vikvs64/pmod-dvi/PMOD_connected.jpg

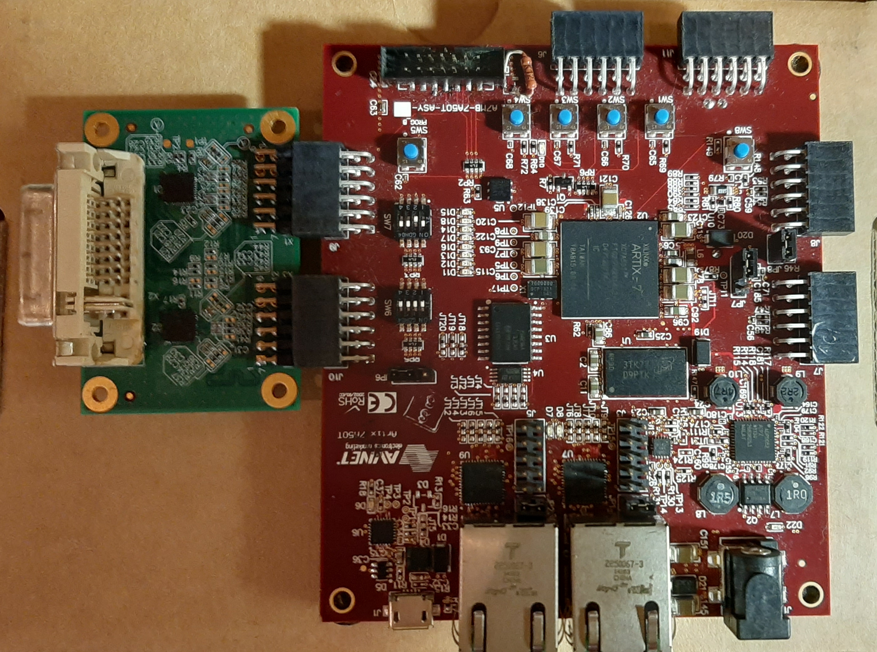
PMOD_connected.jpg
