vikvs64/pmod-dvi/PMOD_DVI_D.jpg

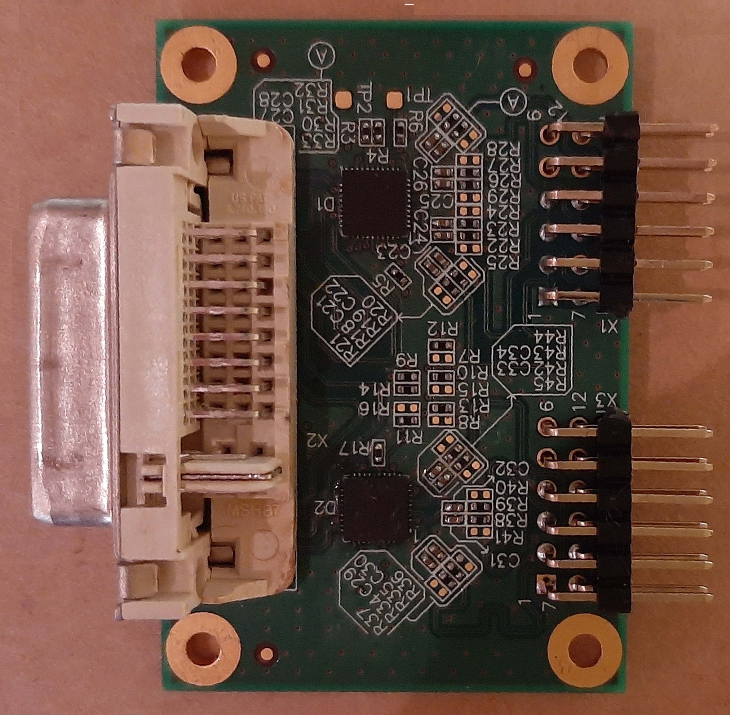
PMOD_DVI_D.jpg
