vikvs64/pmod-dvi/README.md

# pmod-dvi open source hardware project

Wide DVI display controller with PMOD interface

Tested in 1920x1080@120Hz mode with Digilent's Genesys-2 Board. Fpga test based on Will Green's Verilog [code](https://projectf.io/posts/video-timings-vga-720p-1080p/) 
This code also avaliable on GitHub: [projf project](https://github.com/projf/display_controller)

Hardware design based on TI's [SN75DP139RSBR](https://www.ti.com/product/SN75DP139) Chip with TMDS Clock Rates up to 340 MHz. Complete set of files for manufacturing are includes

## Pmod foto
Pmod

## Project structure

    HW - schematic and design files (BOM, Gerbers ...)

    HDL - Double link 1920x1080@120Hz mode test design Verilog source files for Genesys-2 Demo Board 

## More fotos

Genesys-2 Board with PMOD connected

1920x1080@120Hz picture
