vikvs64/pmod-dvi/hw/PMOD DVI-D_BOM_v1.1.xls

Designator | UID | Manufacturer | Partnumber | Size | Value | TC | Voltage | Tolerance | Quantity | DoNotPlace
C1, C2, C11, C12 | C-0402-X5R-16-1uF M | Murata | - | 0402 | 1uF | X5R | 16V | 20% | 4
C3, C4, C5, C6, C7, C8, C9, C10, C13, C14, C15, C16, C17, C18, C19, C20, C21, C22, C23, C24, C25, C26, C27, C28, C29, C30, C31, C32, C33, C34 | C-0402-X7R-16-0.1uF M | Murata | - | 0402 | 0.1uF | X7R | 16V | 20% | 30
D1, D2 | D-SN75DP139RSBR | Texas Instruments | SN75DP139RSBR | - | - | - | - | - | 2
L1, L2 | F-BLM18AG121SN1D | Murata | BLM18AG121SN1D | 0603 | 120R | - | - |  | 2
R1, R2, R7, R8, R15, R16 | R-0402-4K7 F | Yageo | - | 0402 | 4.7k | - | - | 1% | 6 | DNP
R3, R4, R9, R10, R11, R12, R13, R14 | R-0402-4K7 F | Yageo | - | 0402 | 4.7k | - | - | 1% | 8
R5 | R-0402-150R F | Yageo | - | 0402 | 150 | - | - | 1% | 1
R6, R17 | R-0402-4K02 F | Yageo | - | 0402 | 4.02k | - | - | 1% | 2
R18, R19, R22, R23, R26, R27, R30, R31, R34, R35, R38, R39, R42, R43 | R-0402-0R F | Yageo | - | 0402 | 0 | - | - | - | 14
R20, R21, R24, R25, R28, R29, R32, R33, R36, R37, R40, R41, R44, R45 | R-0402-49R9 F | Yageo | - | 0402 | 49.9 | - | - | 1% | 14 | DNP
R46, R47, R48, R49, R50, R51, R52, R53, R54, R55, R56, R57, R58, R59 | R-0402-49R9 F | Yageo | - | 0402 | 49.9 | - | - | 1% | 14
X1, X3 | X-PLD-12R | - | PLD-12R | - | - | - | - | - | 2
X2 | X-0743201004 | Molex | 743201004 | - | - | - | - | - | 1
