vikvs64/pmod-dvi/hw/PMOD_DVI-D_Board_Assembly.PDF

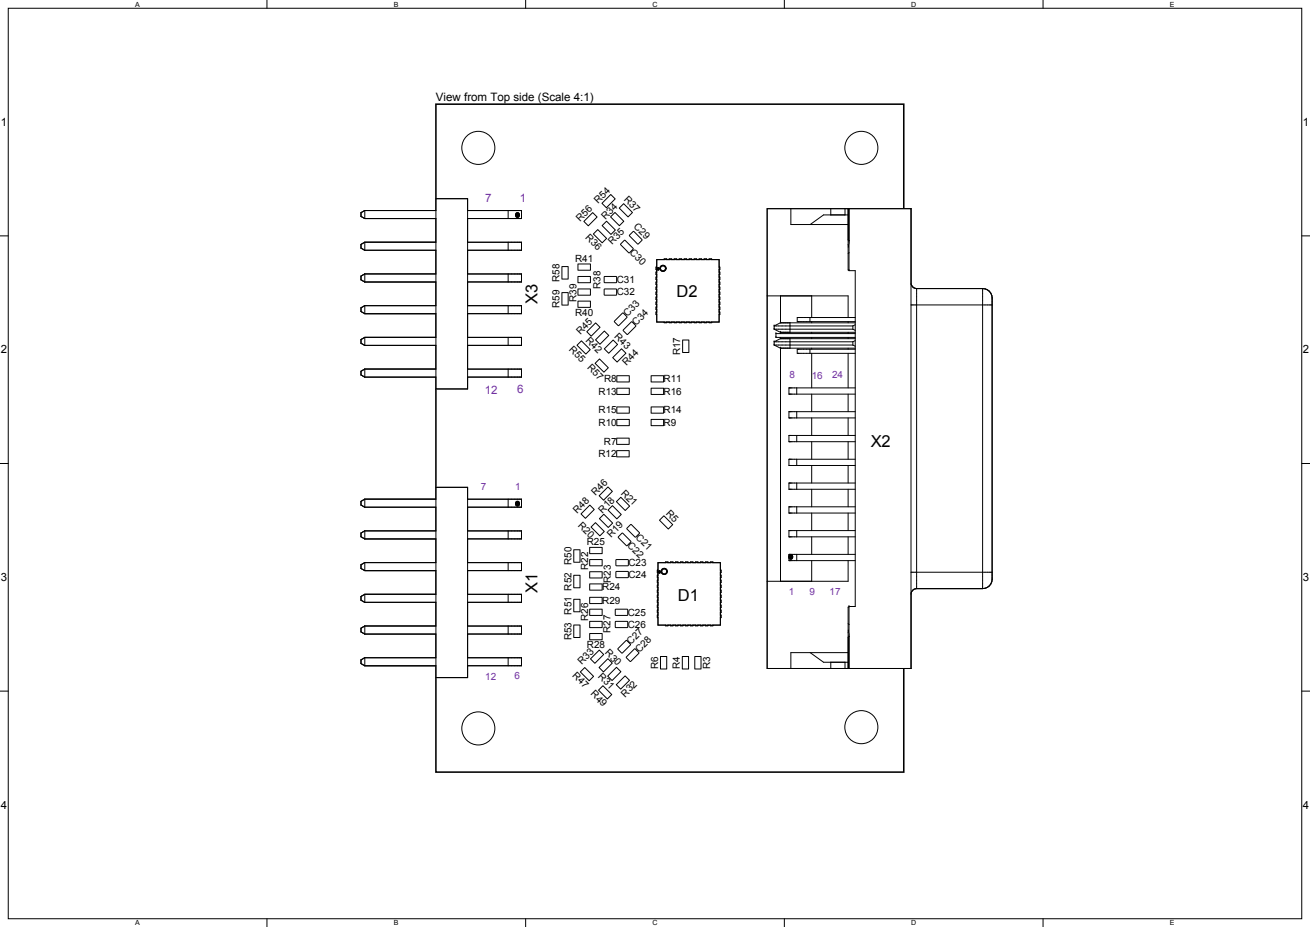
[picture p3: page 1]

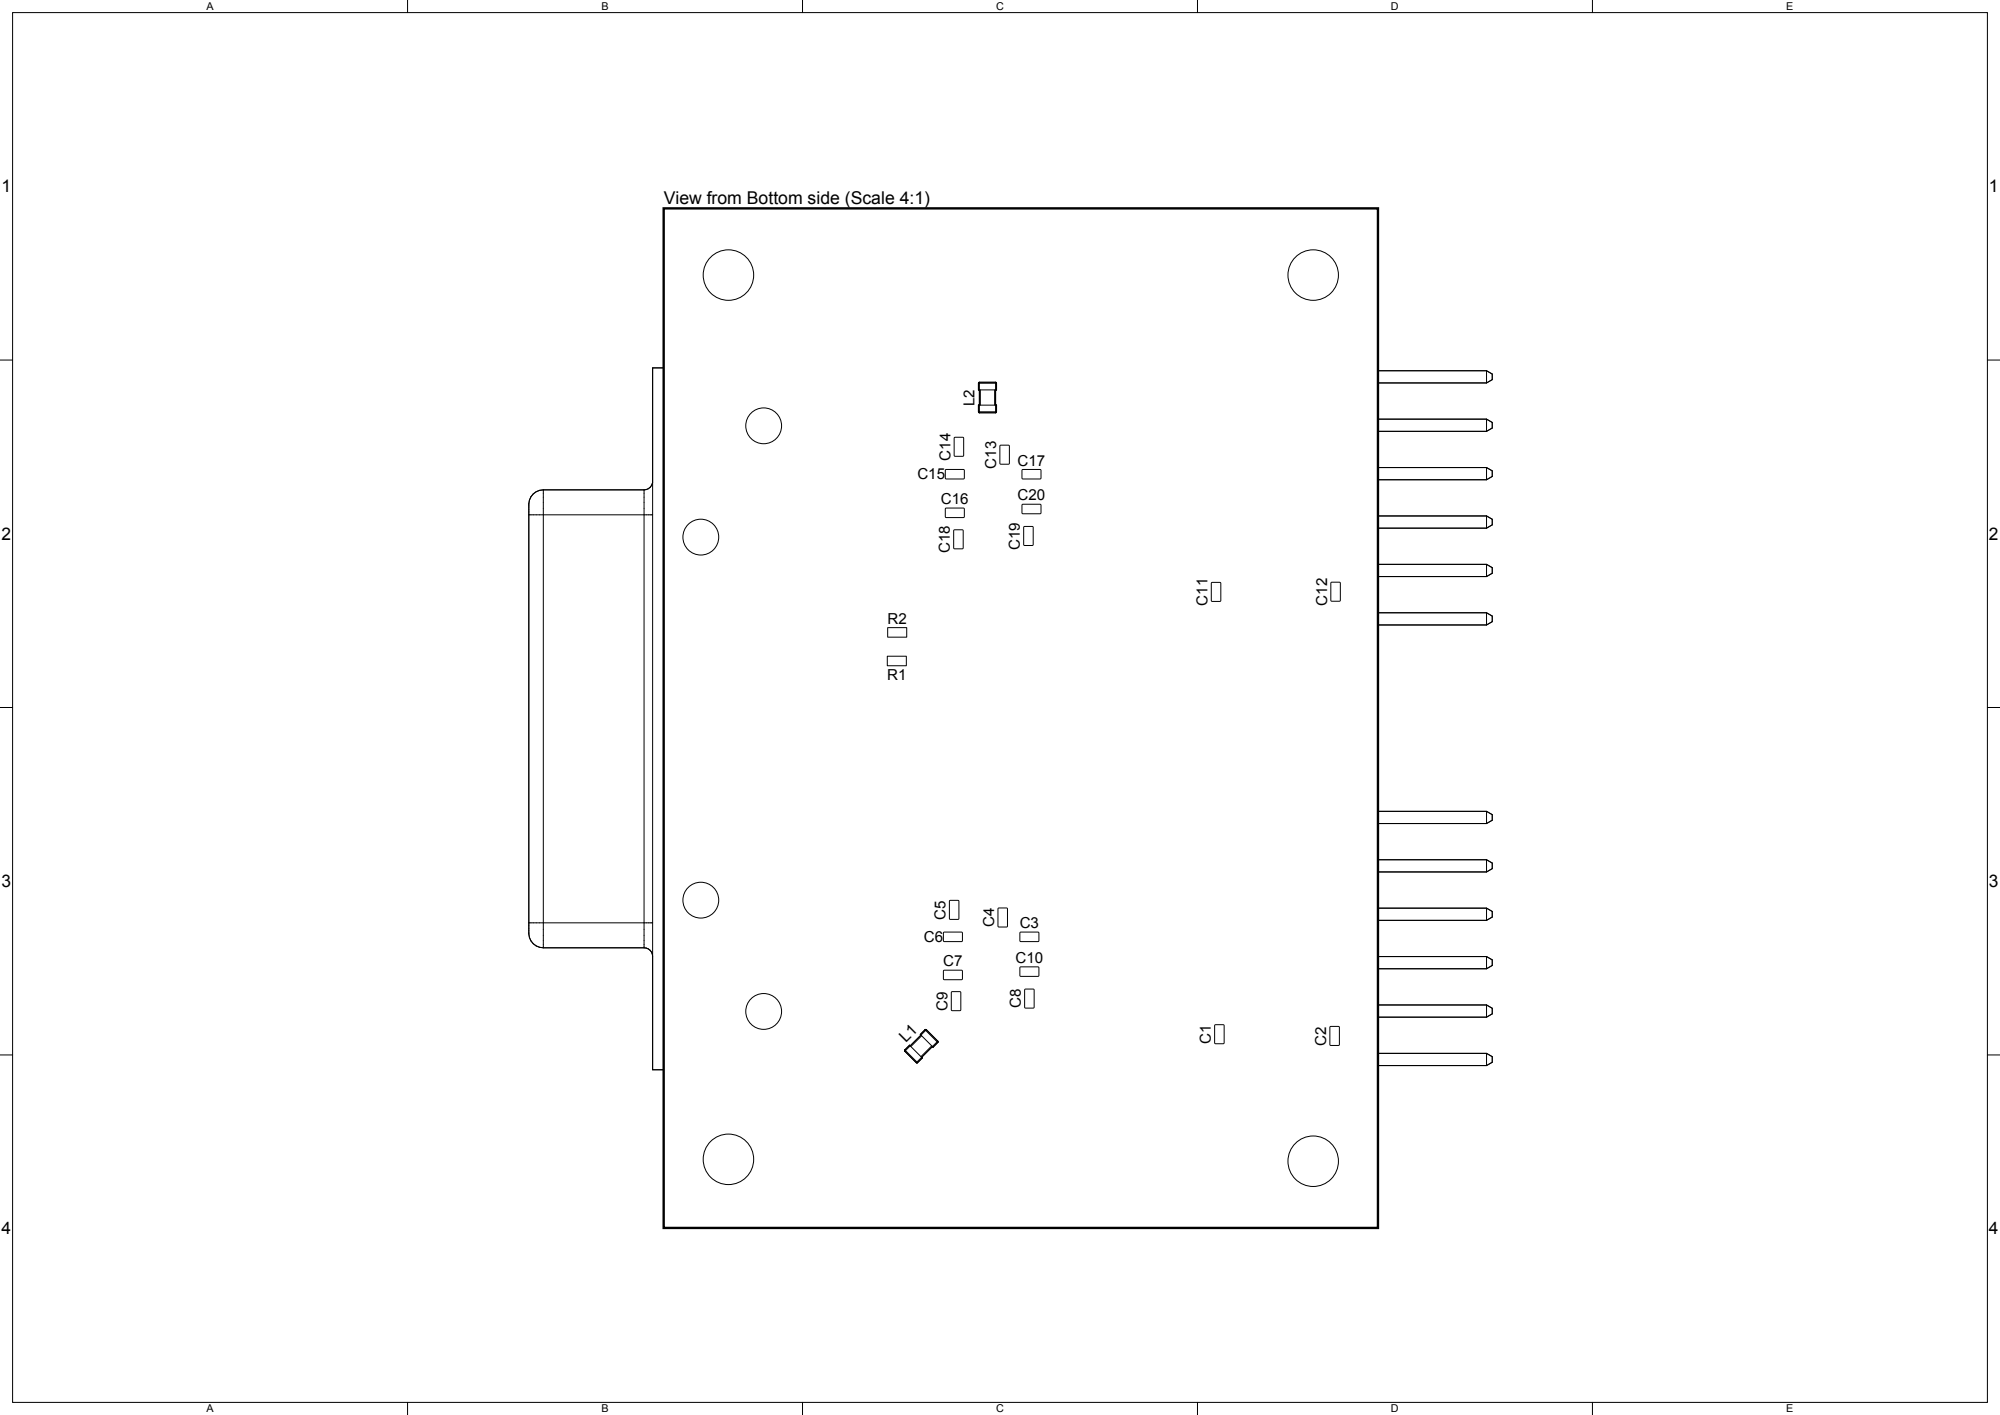
[picture p4: page 2]

View from Bottom side (Scale 4:1)

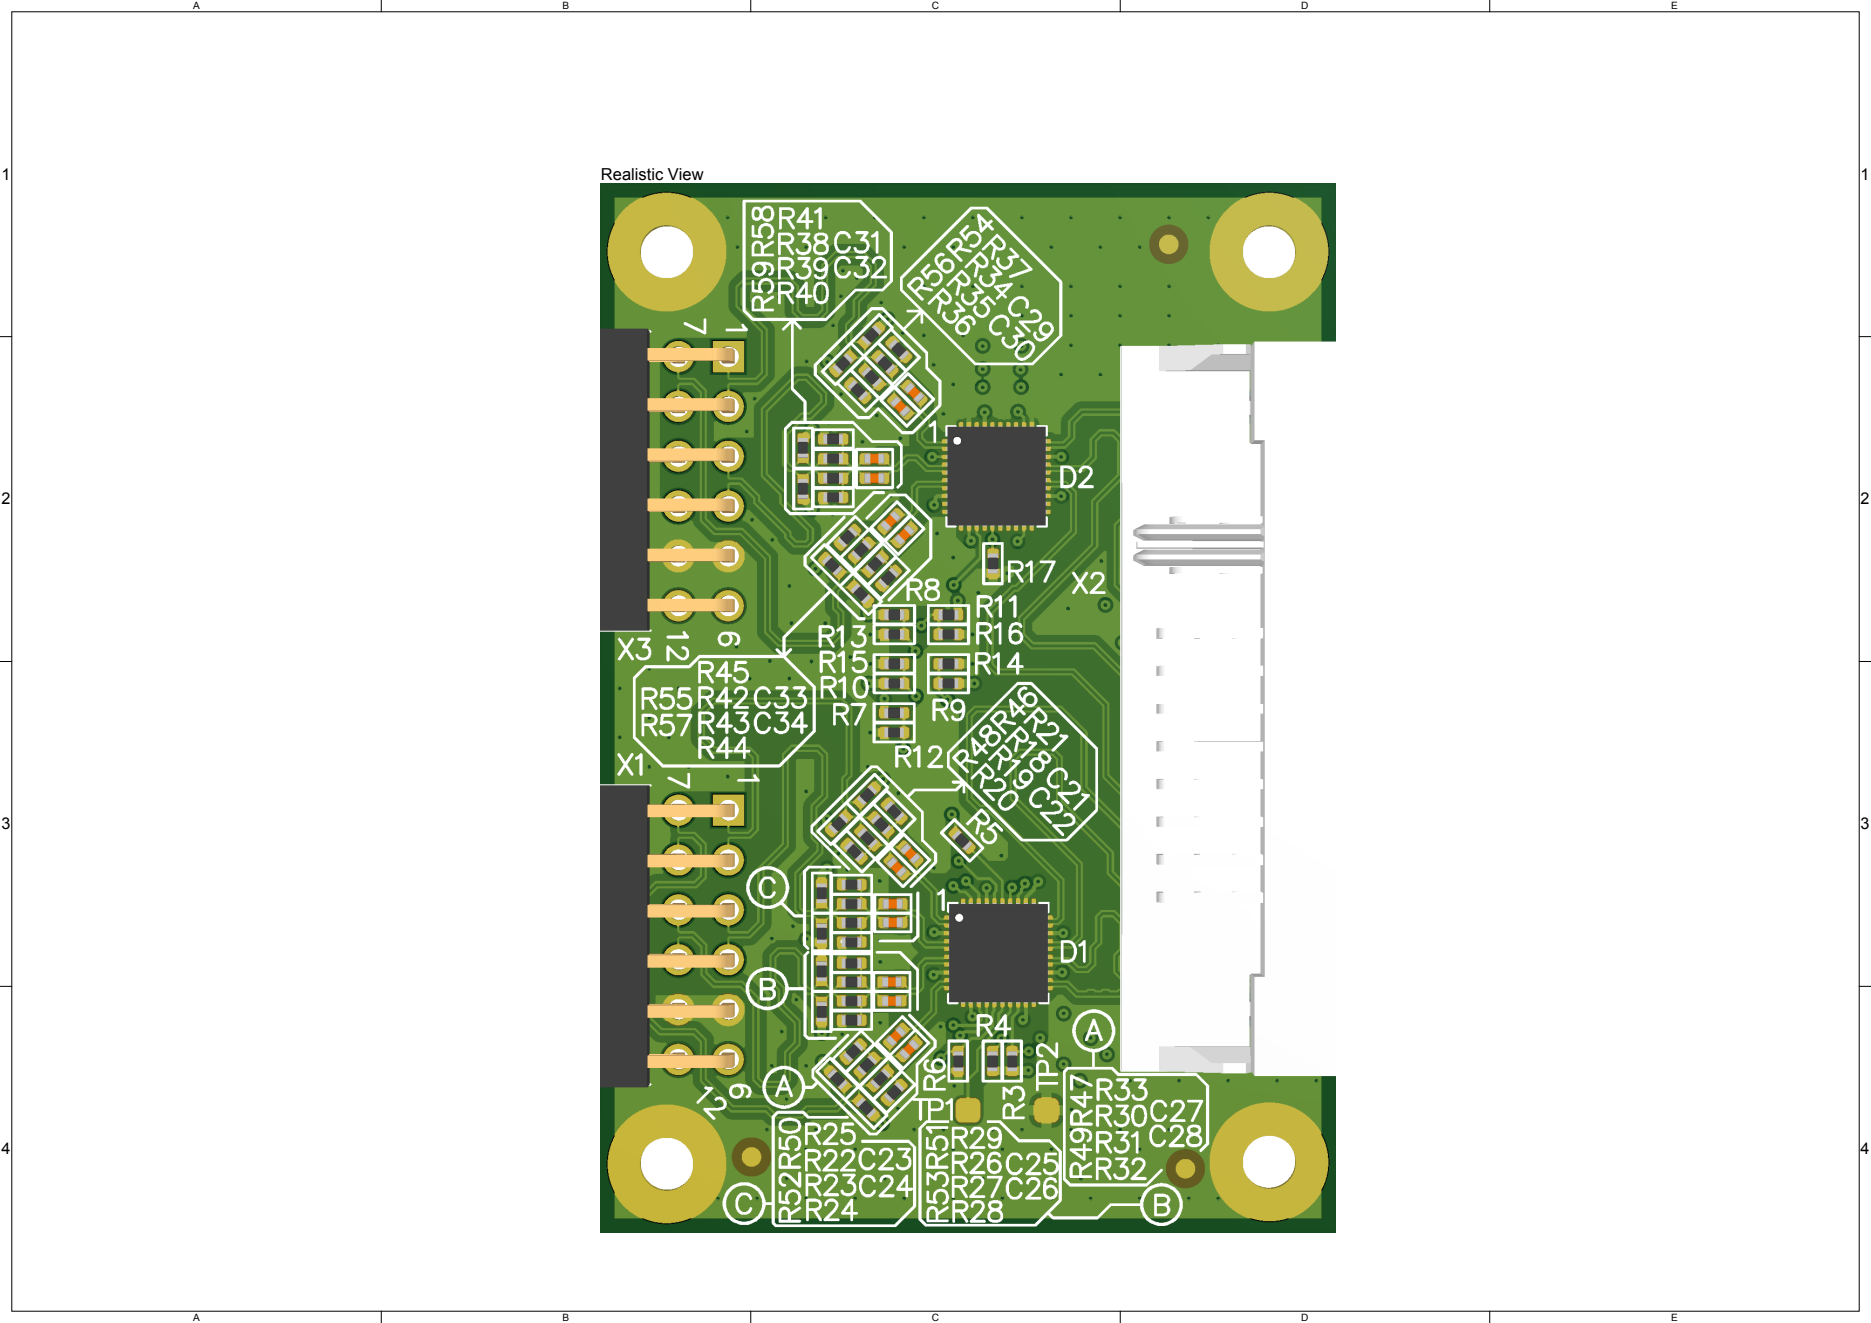
[picture p5: page 3]

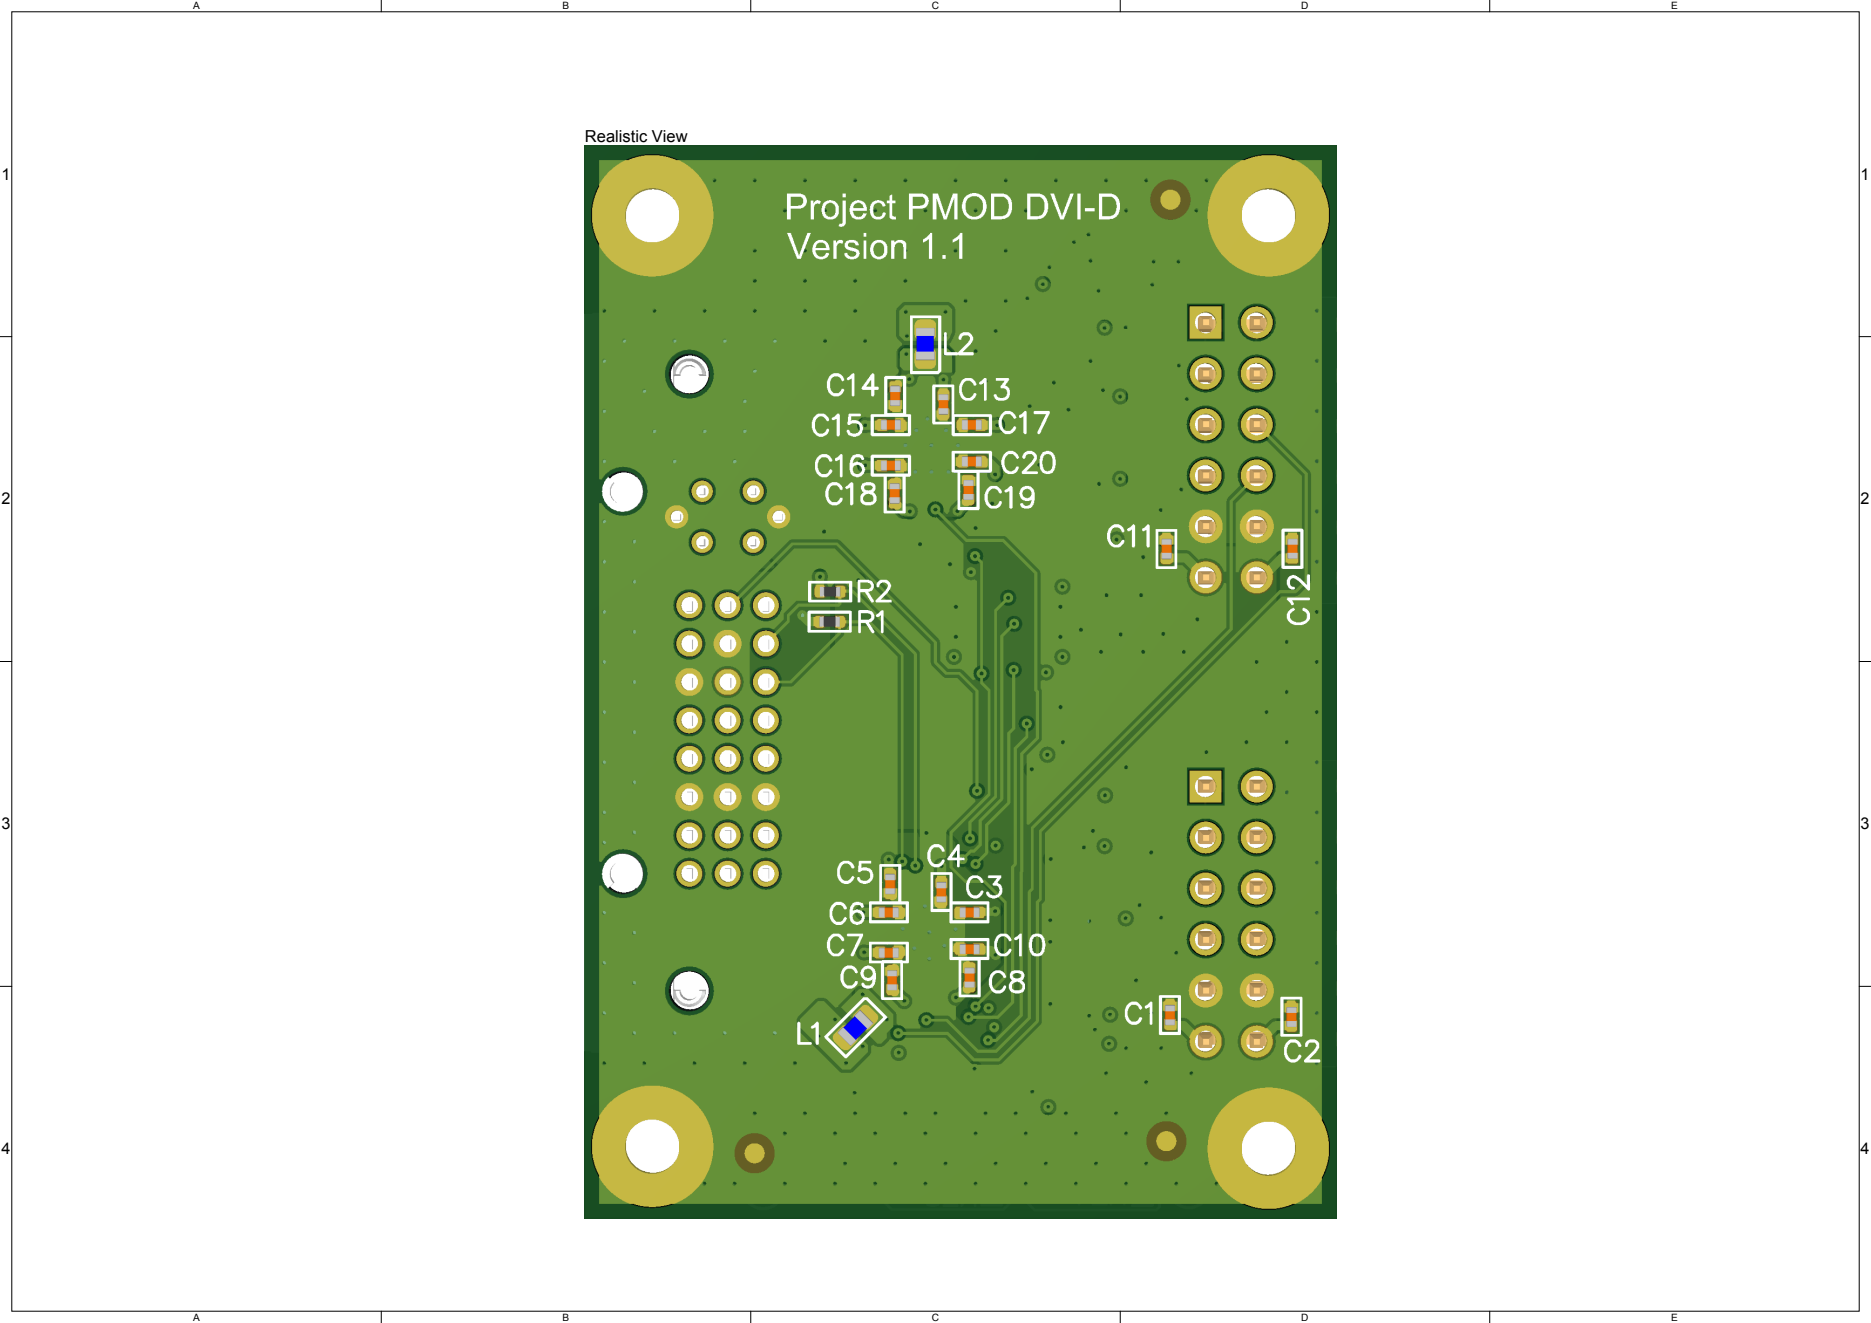
[picture p6: page 4]
