vikvs64/pmod-dvi/hw/PMOD DVI-D_SCH_v1.1.PDF

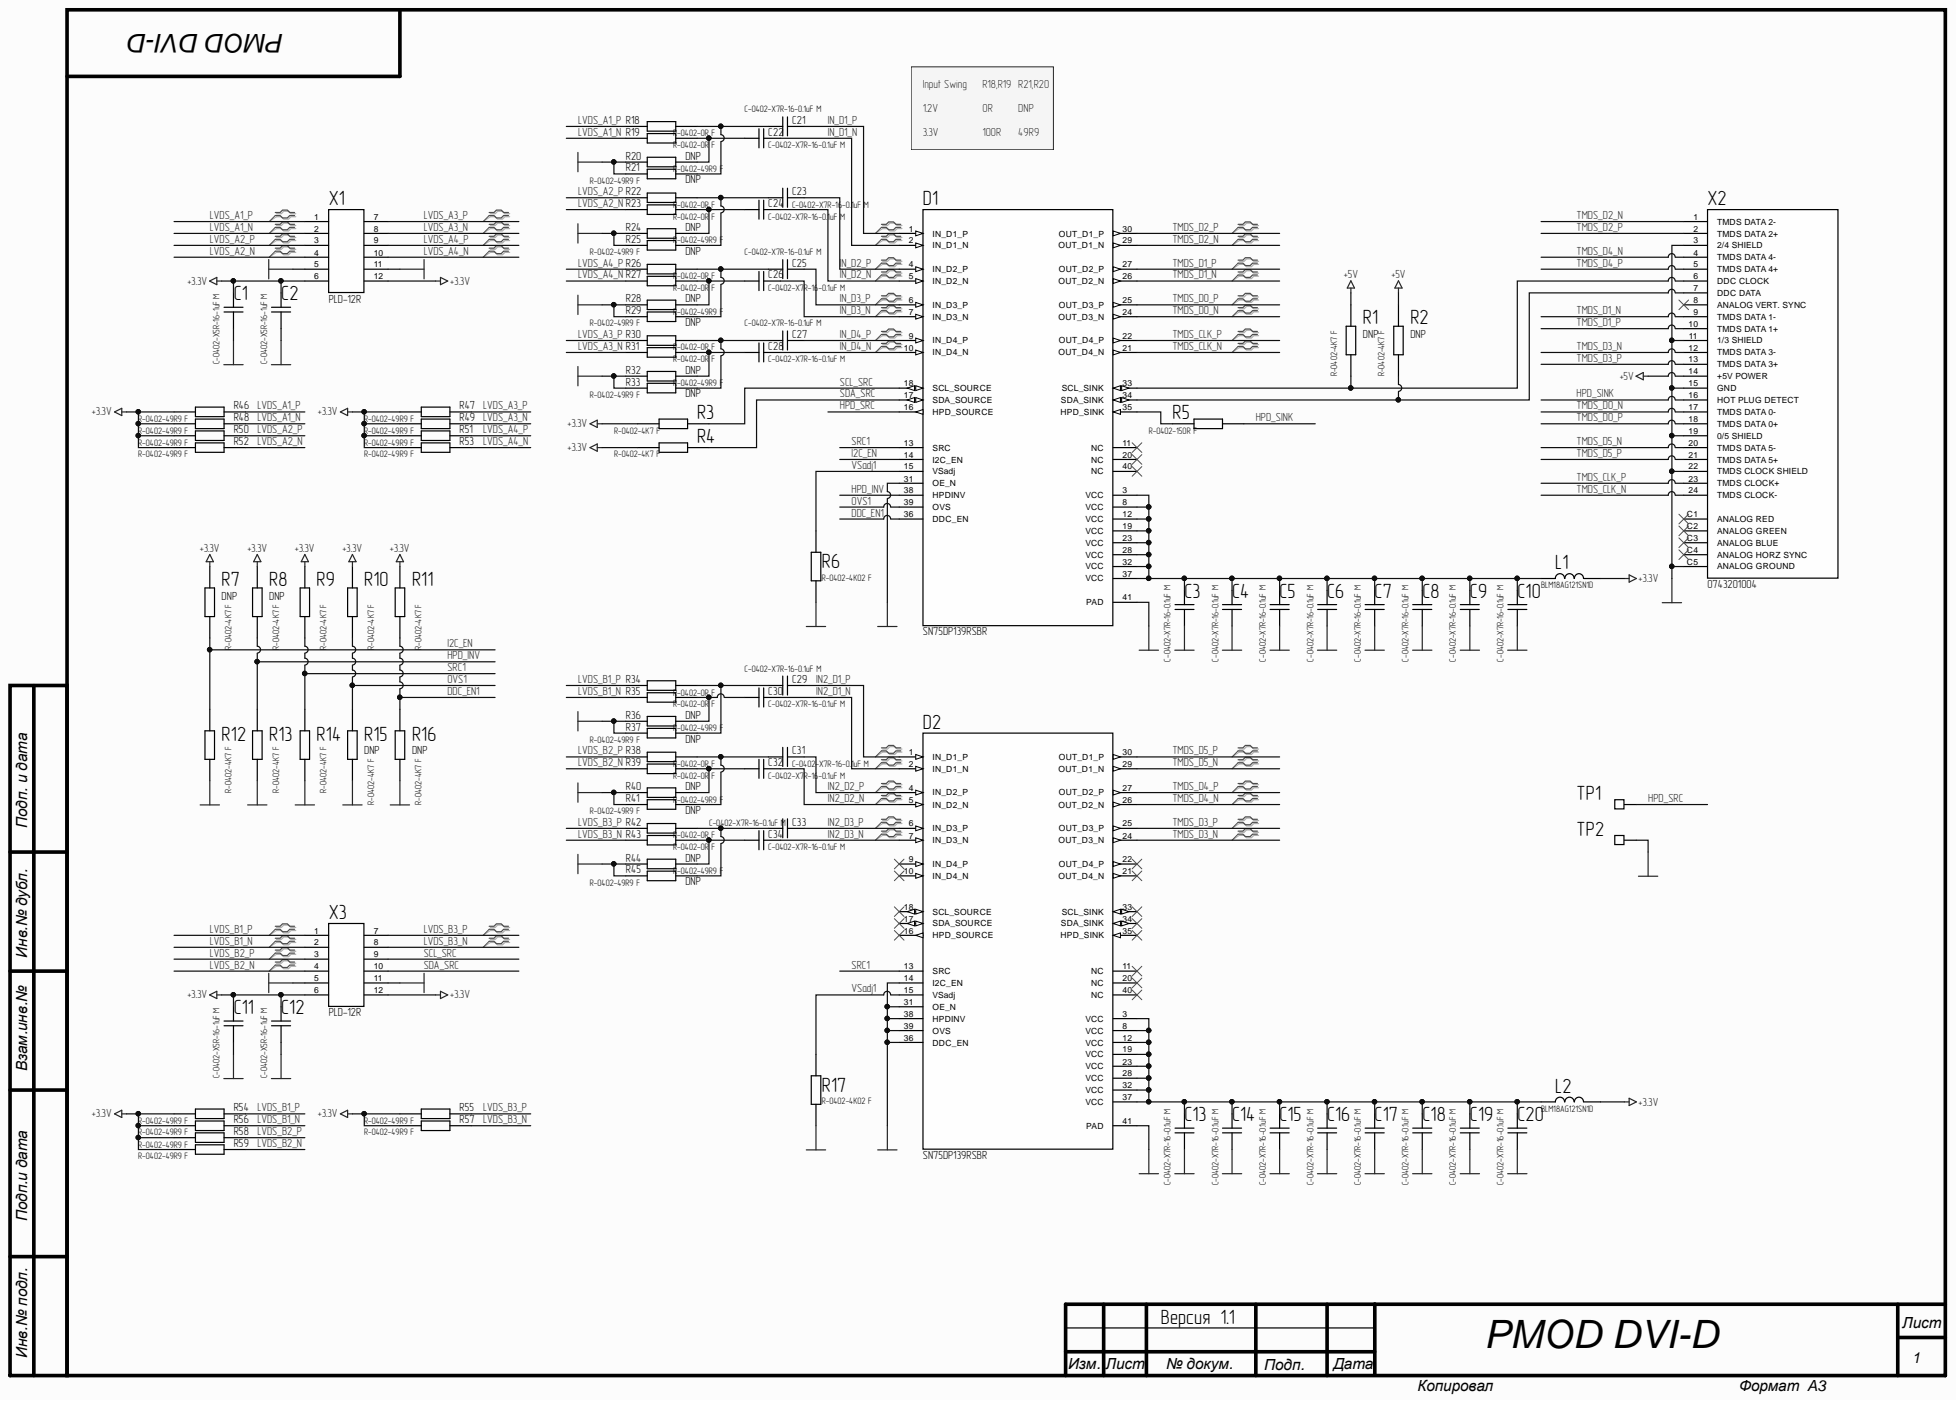
[picture p7: page 1]

F | C22 | IN_D1 _ N

Инв.№ подл. Подп.и дата Взам.инв.№ Инв.№ дубл. Подп. и дата

1 5
3 1

3 9 | 8
3 6 | 1 2

1 9
2 3
2 8
3 2

R-0402-49R9 | F | R5 6 LVDS_B1 _ N | R-0402-49R9
R-0402-49R9 | F | R5 8 LVDS_B2_ P
R-0402-49R9 | F | R5 9 LVDS_B2_ N
